mkvesala/CMPS14-ESP32-SignalK-gateway/README.md

# CMPS14-ESP32-SignalK Gateway








## Disclaimer

This is a personal hobby project. It is provided "as is", without warranty of any kind. See LICENSE.

This firmware is NOT intended for navigation or for any safety-critical use at sea. Do not rely on the data it produces (such as heading, depth or position) to navigate a vessel. Always use certified navigation equipment and proper seamanship.

You use this code entirely at your own risk. The author accepts no liability for any damage, injury or loss arising from its use.

## Introduction

ESP32-based reader for Robot Electronics [CMPS14](https://www.robot-electronics.co.uk/files/cmps14.pdf) compass & attitude sensor. Sends heading, pitch and roll to [SignalK](https://signalk.org) server via websocket/json and to other ESP32 devices via ESP-NOW.

Applies installation offset, deviation and magnetic variation to raw angle to determine compass heading, magnetic heading and optionally true heading. Computes deviation at any compass heading, based on user-measured deviations at 8 cardinal and intercardinal directions. Subscribes magnetic variation from SignalK server. This is prioritized over manually entered variation to determine true heading.

Uses LCD 16x2 to show status messages and heading. If no wifi around, runs on LCD only.

Runs a webserver to provide web UI for CMPS14 configuration. Configurable parameters: calibration mode (full auto, auto, manual), installation offset, measured deviations, manual variation, heading mode (true, magnetic) and attitude leveling. Web UI protected with session-based authentication.

OTA updates and persistent storage of configuration and web UI password in ESP32 NVS are enabled.

Led indicators for calibration mode and connection status (two leds).

Developed and tested on:
- [SH-ESP32](https://docs.hatlabs.fi/sh-esp32/) development board (2.2.1)
- [ESP32 board package](https://github.com/espressif/arduino-esp32) (3.3.8)
- [Arduino IDE](https://www.arduino.cc/en/software/) (2.3.8)
- SignalK Server (2.24.0)
- CMPS14 sensor (V7)

Integrated via ESP-NOW to:
- [ESP32-Crowpanel-compass multi-function display](https://github.com/mkvesala/ESP32-Crowpanel-compass) (v4.0.0)

## Purpose of the project

This is one of my individual digital boat projects. Use at your own risk. Not for safety-critical navigation.

1. I needed a reliable low-cost digital compass that could be connected to SignalK server of my vessel
2. I wanted to learn ESP32 capabilities for other digital boat projects that are on my backlog
3. I felt I had to refresh my C/C++ skills as I had not delivered any code since 2005 (and before that mostly Java and Smallworld Magik)

The project started as procedural .ino implementation in Arduino. Later, refactoring to class structure was done. That developed into a design pattern that I currently use in all similar sensor projects of my boat.

## Release history

| Release | Branch | Comment |
|---|---|---|
| v2.1.6  | main | Latest release. ArduinoJson 7 API migration: deprecated calls replaced, SignalK traffic unchanged. See CHANGELOG. |
| v2.1.5  | main | WiFi outage recovery: the radio stays on, so ESP-NOW keeps broadcasting while the router is down, and WiFi and SignalK reconnect by themselves. See CHANGELOG. |
| v2.1.4  | main | Shared `espnow_protocol.h` synced with the fleet-wide copy (adds `HALMET_OIL_DELTA` (10)). Wire format unchanged, no firmware logic changes. See CHANGELOG. |
| v2.1.3  | main | Magnetic variation is subscribed from SignalK immediately when heading mode is switched to True (no reconnect needed). README: MCP integration section, `MCP_API_TOKEN` in secrets example, cross-check fixes. See CHANGELOG. |
| v2.1.2  | main | Documentation update only. |
| v2.1.1  | main | Shared `espnow_protocol.h` synced to the fleet-wide superset (new message types 7 and 8, ownership rules documented). Wire format unchanged, no firmware logic changes. See CHANGELOG. |
| v2.1.0  | main | Machine-readable `/deviations` JSON endpoint and static API-token (`X-Auth-Token`) auth for machine clients (e.g. the `mcp-cmps14/` MCP tool). Additive, backward compatible. See CHANGELOG. |
| v2.0.0  | main | ESP-NOW level command removed. WiFi AP security, intrusion detection, pitch/roll SignalK fix, WebSocket ping/pong liveness. See CHANGELOG. |
| v1.3.1  | main | Documentation patch, no source code changes. |
| v1.3.0  | main | Breaking change in ESP-NOW wire protocol. See CHANGELOG for details. |
| v1.2.0  | main | Added ESP-NOW communication. See CHANGELOG for details. |
| v1.1.0  | main | Added web authentication. See CHANGELOG for details. |
| v1.0.1  | main | See CHANGELOG for details. |
| v1.0.0  | main | Refactored into classes with new features not implemented in v0.5.x. |
| v0.5.1  | legacy/procedural-0.5.x | Last fully procedural version. |

## Classes

### Class CMPS14Sensor

The heart of the project is the modest library-like class `CMPS14Sensor` which communicates with the CMPS14 device. It has the following public API:

| Method | Returns | Comment |
|---|---|---|
| `begin(TwoWire &wirePort)` | `bool` | Initialize sensor |
| `available()` | `bool` | Check the availablility of the sensor |
| `read(float &angle_deg, float &pitch_deg, float &roll_deg)` | `bool` | Read sensor raw values (degrees) to the float variables |
| `sendCommand(uint8_t cmd)` | `bool` | Send any command to the sensor |
| `readRegister(uint8_t reg)` | `uint8_t` | Read any register of the sensor |
| `isAck(uint8_t byte)` | `bool` | Return true if byte is ACK |
| `isNack(uint8_t byte)` | `bool` | Return true if byte is NACK |

The simple usage of CMPS14Sensor could be:

```
#include <Arduino.h>
#include <Wire.h>
#include "CMPS14Sensor.h"

CMPS14Sensor sensor(0x60); // I2C address

void setup() {
   Serial.begin(115200);
   Wire.begin(16, 17); // SDA, SCL
   delay(100);
   sensor.begin(Wire);
}

void loop() {
   const unsigned long now = millis();
   static unsigned long last = 0;
   if ((long)(now - last) < 1000) return; // Read at 1 Hz
   float angle_deg = 0.0f, pitch_deg = 0.0f, roll_deg = 0.0f;
   if (sensor.available() && sensor.read(angle_deg, pitch_deg, roll_deg)) {
      Serial.println(angle_deg);
      Serial.println(pitch_deg);
      Serial.println(roll_deg);
   }
}

```
### Other classes

Class diagram including companion projects:



**`CMPS14Processor`:** 
- Owns: `DeviationLookup`
- Uses: `CMPS14Sensor`, `CalMode` and `TwoWire`
- Owned by: `CMPS14Application`
- Responsible for: the main business logic, acts as "the compass"

**`CMPS14Preferences`:** 
- Owns: `Preferences`
- Uses: `CMPS14Processor` and `CalMode`
- Owned by: `CMPS14Application`
- Responsible for: loading and saving data to ESP32 NVS

**`SignalKBroker`:** 
- Owns: `WebsocketsClient` (via `std::unique_ptr`, recreated fresh on every reconnect)
- Uses: `CMPS14Processor`
- Owned by: `CMPS14Application`
- Responsible for: communication with SignalK server

**`ESPNowBroker`:** 
- Uses: `CMPS14Processor`
- Owned by: `CMPS14Application`
- Responsible for: communication via ESP-NOW protocol

**`DisplayManager`:**
- Owns: `LiquidCrystal_I2C`
- Uses: `CMPS14Processor`, `SignalKBroker`, `WifiState` and `CalMode`
- Owned by: `CMPS14Application`
- Responsible for: LCD display and LEDs, acts as "the display"

**`WebUIManager`:**
- Owns: `WebServer`
- Uses: `CMPS14Processor`, `CMPS14Preferences`, `SignalKBroker`, `DisplayManager` and `CalMode`
- Owned by: `CMPS14Application`
- Responsible for: providing web user interface, acts as "the webui"

**`CMPS14Application`:**
- Owns: `CMPS14Sensor`, `CMPS14Processor`, `CMPS14Preferences`, `SignalKBroker`, `ESPNowBroker`, `DisplayManager` and `WebUIManager`
- Uses: `WifiState` and `CalMode`
- Responsible for: orchestrating everything within the main program, acts as "the app"

**`DeviationLookup`:**
- Owned by: `CMPS14Processor`
- Responsible for: deviation lookup table

**`CalMode`:**
- Global enum class for different calibration modes of CMPS14

**`WifiState`:**
- Global enum class for different WifiStates maintained and shared by `CMPS14Application` 

## Features

### Compass and attitude

1. Reads angle, pitch and roll from CMPS14 at ~20 Hz frequency
2. Applies installation offset (user input) to raw angle for compass heading
3. Applies smoothing to compass heading
4. Applies deviation on compass heading for magnetic heading
5. Computes true heading (optional), using either
   - Live *navigation.magneticVariation* received from SignalK (prioritized over user input)
   - Manual variation from user input on web UI (used automatically whenever *navigation.magneticVariation* is not available)
6. Applies leveling to pitch and roll
7. Installation offset, selected heading mode and pitch/roll leveling are stored persistently in ESP32 NVS and restored automatically on boot

### Deviation

1. Takes 8 user-measured deviations (N, NE, E, SE, S, SW, W, NW) as input from web UI
2. Computes 5 harmonic coefficients (A, B, C, D, E) that best fit the mathematical model `deviation(θ) = A + B·sin(θ) + C·cos(θ) + D·sin(2θ) + E·cos(2θ)` using least squares regression and Gauss-Jordan elimination, providing smooth sinusoidal curve through all 8 user-measured points
3. User-measured deviations and computed 5 coeffs are stored persistently in ESP32 NVS
4. A deviation lookup table is computed each time the 5 coeffs change and on ESP32 boot. The lookup table contains the deviation for each 1° over 360°. The lookup method will apply a linear interpolation for better accuracy when retrieving a value from the lookup table at a compass heading.
5. Deviation curve and deviation table at simplified 10° resolution available on web UI

**Note that deviation can be applied only to a permanently mounted stable compass. While CMPS14 can be securely mounted to the vessel, it's behavior may still be altered by calibration (automatic or manual). It is recommended to keep deviation at 0° until there are undeniable evidence that the compass is stable and operating without any needs for regular calibration. It's obvious that the deviations should always be re-measured and computed after each calibration.**

### Magnetic variation

1. When heading mode is True, subscribes *navigation.magneticVariation* path from SignalK server at ~1 Hz cycles. This is treated as primary and the most trusted source of magnetic variation. The subscription is sent when the SignalK WebSocket connection opens and, if the connection is already open, immediately when the heading mode is switched to True on the web UI.
2. User may enter magnetic variation manually on the web UI. This is a backup and the value will be used automatically if variation is not available at SignalK path.
3. User-defined manual variation is persistently stored in ESP32 NVS.
4. Magnetic variation is used for computing true heading on magnetic heading.

**Note that when the SignalK connection is open, the magnetic heading will always be sent to SignalK *navigation.headingMagnetic* path regardless of the active heading mode (true/magnetic). It is a standard practise to compute true heading on server side using SignalK [Derived Data](https://github.com/SignalK/signalk-derived-data) plugin or similar, or on other clients such as [OpenCPN](https://opencpn.org) that utilize [WMM](https://www.ncei.noaa.gov/products/world-magnetic-model).**

**Note that ESP-NOW packet always contains both true and magnetic heading, regardless of the active heading mode.**

### SignalK communication

Connects to:
```
ws://<server>:<port>/signalk/v1/stream?token=<optional>
```

**Sends** at maximum ~10 Hz frequency, in radians:

- *navigation.headingMagnetic* — sent when heading changes by more than 0.05°
- *navigation.attitude.pitch* — included in every heading delta
- *navigation.attitude.roll* — included in every heading delta
- *(optionally) navigation.headingTrue*

**Receives** at ~1 Hz frequency, in radians:

1. *navigation.magneticVariation* (if available at SignalK, subscribed only when heading mode is True)

**Please refer to Security section of this file.**

### Connection resilience

The SignalK WebSocket is kept alive and recovered on multiple layers:

- **Ping/pong liveness (primary):** while the socket is open the gateway sends a client ping every ~10 s (`WS_PING_MS`) and timestamps every server pong. If no pong arrives within ~30 s (`PONG_TIMEOUT_MS`), `SignalKBroker::isStale()` reports the connection dead and the gateway closes and reconnects it — a **graceful transport-level reconnect, without restarting the device**, so uptime, ESP-NOW peers and the display state are preserved. This catches the *half-open TCP* failure mode where WiFi and `isOpen()` still look healthy but the server side has silently frozen (e.g. the SignalK host entering power-saving).
- **Exponential backoff:** when the socket is closed, reconnect attempts start at `WS_RETRY_MS` (~2 s) and double up to `WS_RETRY_MAX_MS` (~2 min).
- **Fresh client per reconnect:** `SignalKBroker` owns the `WebsocketsClient` via `std::unique_ptr`; each reconnect builds a brand-new client and destroys the previous one, so every attempt starts from a clean TCP / lwIP socket state. This prevents a stuck underlying socket from making all future reconnects fail permanently until a reboot — a failure mode that could appear only after prolonged uptime (~12–48 h) even while WiFi, heap and the main loop stayed healthy.
- **Watchdogs (last-resort fallback):** the network watchdog (`ESP.restart()` after ~10 min of a silent-but-associated link) and the loop-runtime watchdog (restart if the loop runtime EMA stays degraded) remain in place as a safety net. Individual iteration times are clamped (`LOOP_SAMPLE_CAP_US`) before entering the EMA, so a single blocking call — a `ws.connect()` against an unreachable host, the WiFi teardown delay — cannot trip the watchdog on its own; the unclamped peak is still reported on the LCD and in `/status` (`runtime_peak`) for diagnostics. With ping/pong liveness handling the common case, both watchdogs are expected to stay dormant and may be removed in a future release once liveness is field-proven.
- **Restart cause is preserved:** whichever watchdog fires — and likewise a restart from the web UI — records its reason to NVS before rebooting, so `/status` reports it as `last_reset` after the device comes back. The stored reason is consumed on boot, so it always describes only the previous restart. Crashes that never reach the NVS write (panic, brownout) are covered by the separate `esp_reset` field, taken from ESP-IDF's `esp_reset_reason()`.

### ESP-NOW communication

Broadcasts compass data via ESP-NOW protocol for other ESP32 devices such as external displays.

Since v1.3.0 all ESP-NOW messages use the shared `ESPNow::ESPNowPacket` (`ESPNowHeader` + typed payload) packet wrapper defined in `espnow_protocol.h` along with the typed payload structs.

**Sends** at ~20 Hz frequency with a deadband of 0.05°:
- `ESPNow::ESPNowPacket<HeadingDelta>` - payload `HeadingDelta` containing:
  - `heading_rad` (magnetic heading radians)
  - `heading_true_rad` (true heading radians)
  - `pitch_rad` (pitch radians)
  - `roll_rad` (roll radians)

**Broadcast mode:** Uses broadcast address (FF:FF:FF:FF:FF:FF) - any ESP-NOW receiver on the same WiFi channel can listen.

**WiFi coexistence:** ESP-NOW operates alongside WiFi (AP_STA mode). Both SignalK WebSocket and ESP-NOW broadcast function simultaneously.

**WiFi outage:** if the router goes down, ESP-NOW keeps broadcasting: the radio stays on in `WIFI_AP_STA` mode, held on `ESPNOW_CHANNEL` (6) between attempts. Each connection attempt lasts up to ~15 s and retries back off from ~30 s to ~2 min, so WiFi and SignalK return without a reboot.

**Note: ESP-NOW receivers must be on the same WiFi channel as the compass. Simplest approach is to connect both devices to the same WiFi network with a fixed channel.**

### Calibration modes

Three supported calibration modes and use-mode for normal operation:

1. *FULL AUTO* - CMPS14's built-in autocalibration & autosave + optional user configurable stop timer
2. *AUTO* - auto-detect good enough calibration to save automatically
3. *MANUAL* - user-triggered calibration with manual save/replace
4. In *USE* mode the CMPS14 operates normally based on saved calibration profile (no calibration is running).

When calibration is running, *SYS*, *ACC* and *MAG* indicators are monitored at ~2 Hz frequency.

*FULL AUTO* and *AUTO* will activate on ESP32 boot. The *FULL AUTO* will run until the user configured stop timer or eternally if the timer is set to 0. The *AUTO* will run until all three indicators equal 3 (the best) over three consecutive cycles, then the calibration profile will be saved and *USE* mode will be activated. When *USE/MANUAL* is selected, no calibration will be started on ESP32 boot. Instead, the device will start directly to *USE* mode. In *MANUAL* mode (press *CALIBRATE*) user may decide when to save by monitoring the values on web UI status block.

The calibration mode selection (including optional *FULL AUTO* timeout) is stored persistently in ESP32 NVS.

The calibration profile is saved on CMPS14 internally, *not* in ESP32 NVS.

**Note that CMPS14's *GYR* indicator for gyro is not monitored. There is a reported firmware bug in CMPS14 that makes *GYR* indicator unreliable.**

### Web UI (WebServer)

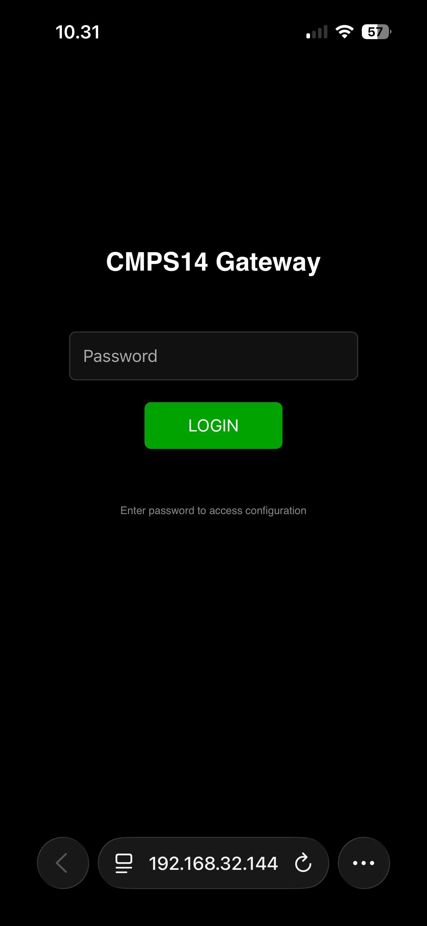
[picture p1: docs/ui0.jpeg]
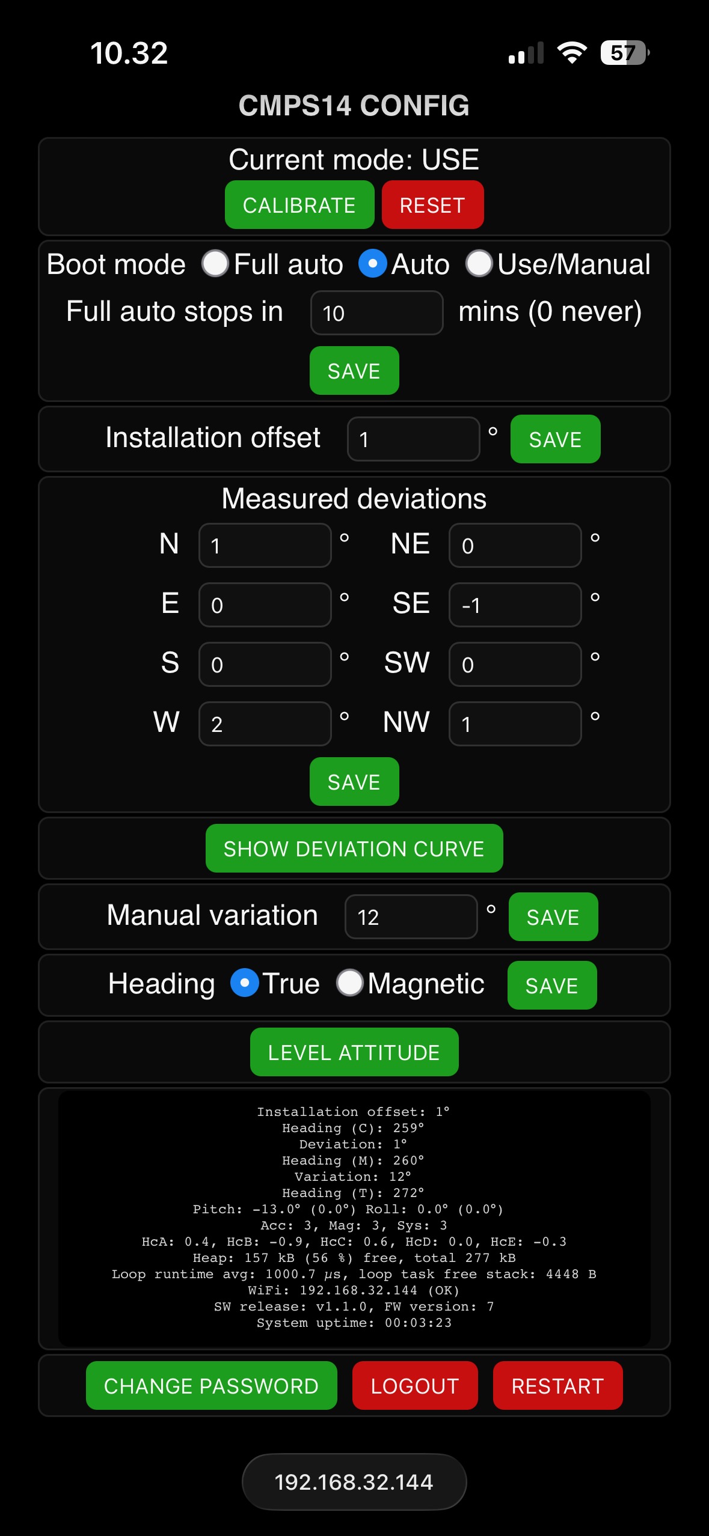
[picture p2: docs/ui1.jpeg]
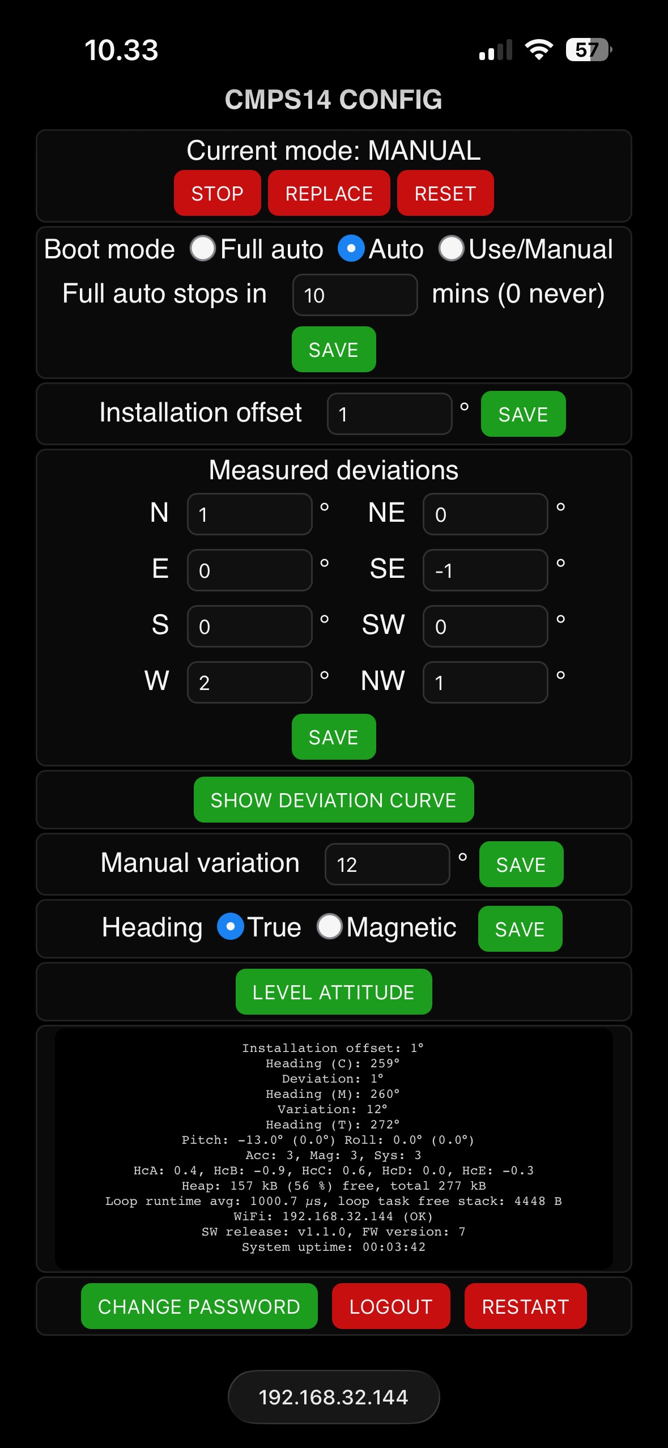
[picture p3: docs/ui2.jpeg]
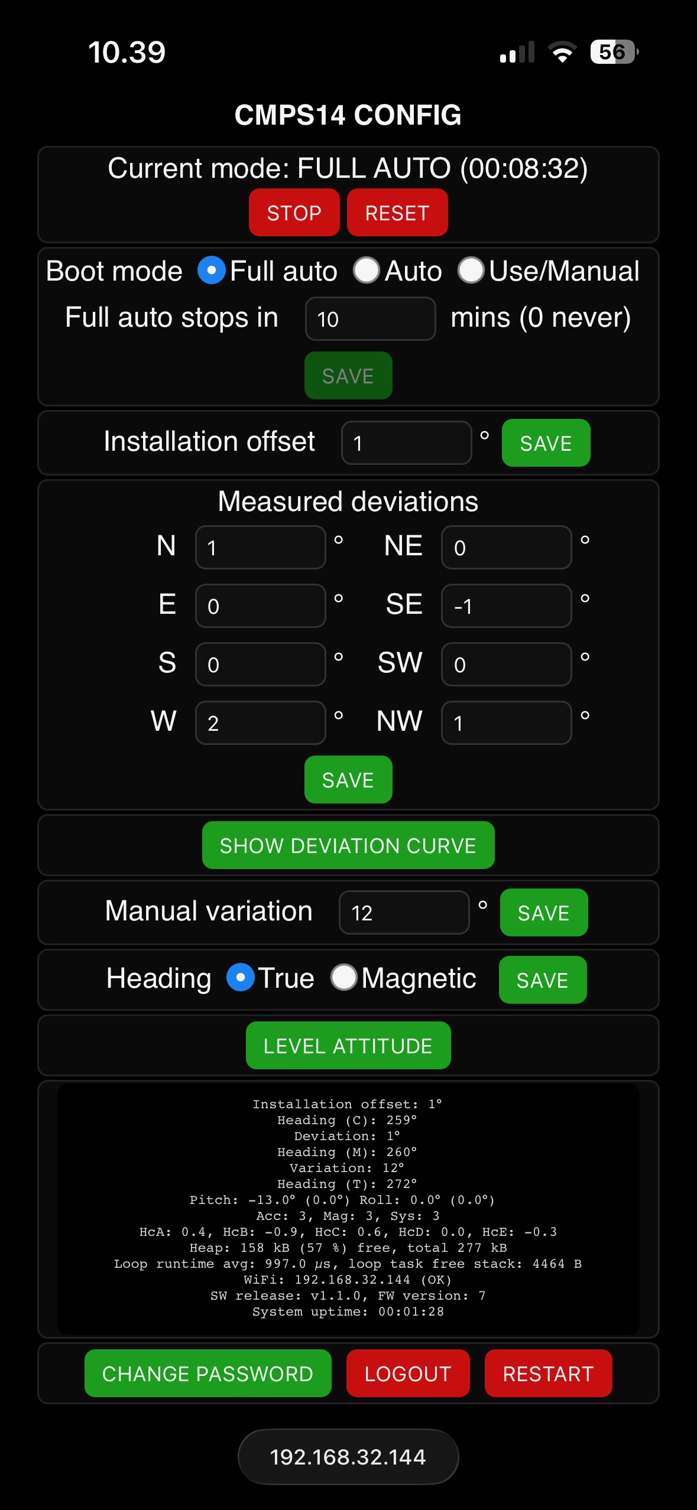
[picture p4: docs/ui3.jpeg]
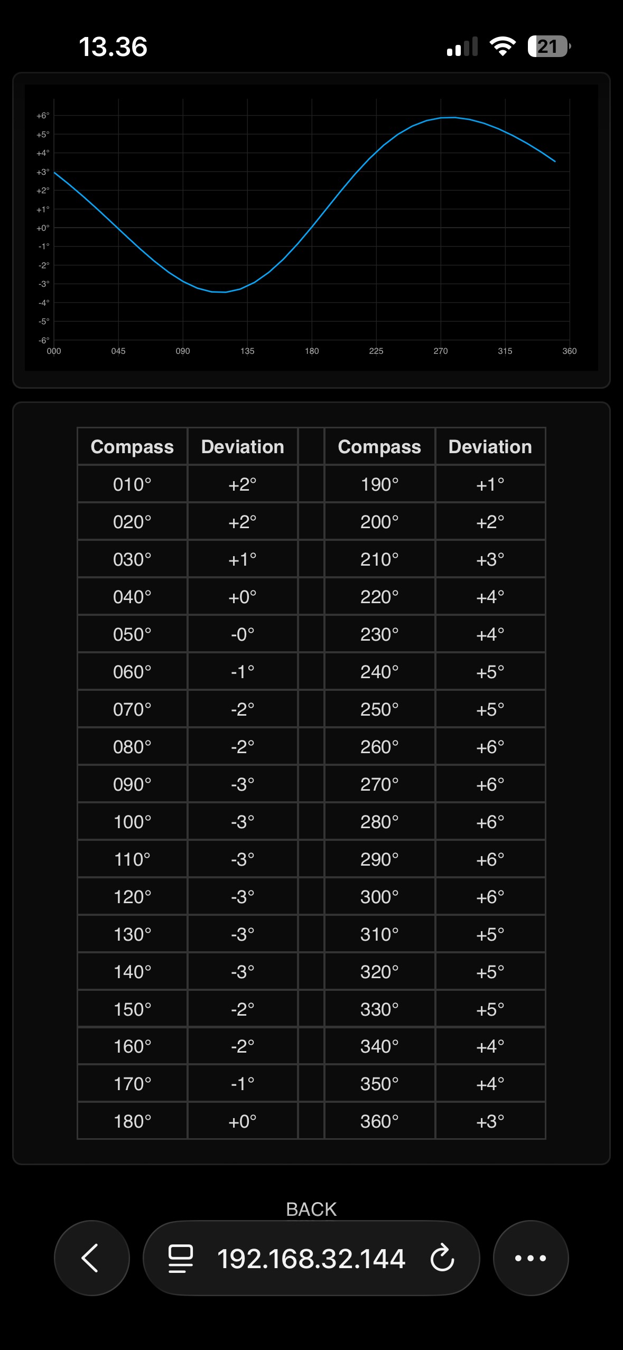
[picture p5: docs/ui4.jpeg]
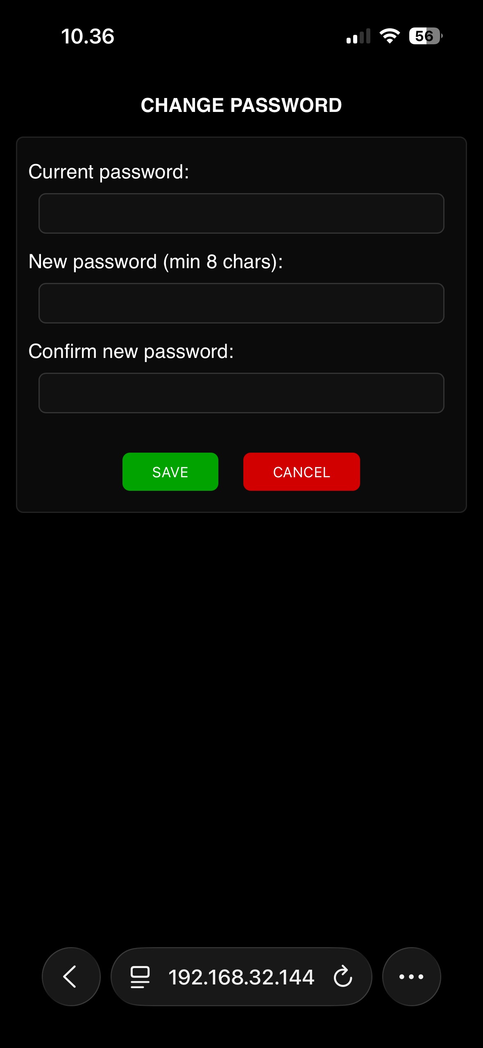
[picture p6: docs/ui5.jpeg]
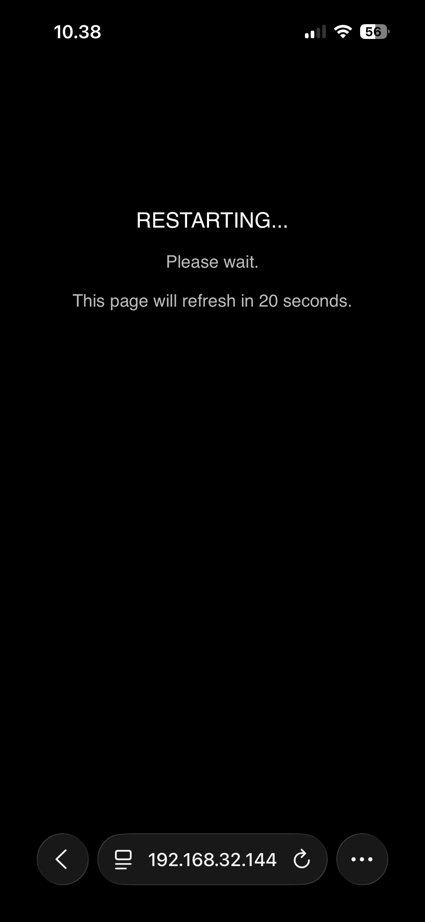
[picture p7: docs/ui6.jpeg]
      

Webserver provides simple responsive HTML/JS user interface for user to configure:

1. Calibration mode on boot and optional *FULL AUTO* timeout (mins)
   - 0 mins timeout never turns *FULL AUTO* mode off automatically
   - Effective after ESP32 boot
2. Installation offset (degrees)
   - Positive offset corrects the heading *towards* starboard, meaning that the compass mounting is tilted port side
   - Negative offset corrects the heading *towards* port side, meaning that the compass mounting is tilted starboard
   - Effective immediately
3. Measured deviations at 8 cardinal and intercardinal directions (degrees)
   - Assumes the user has measured deviations with the standard maritime navigation routine:
     ```
     HDG(C) -> Dev -> HDG(M) -> Var -> HDG(T)
     ```
   - Effective immediately
4. Manual magnetic variation (degrees)
   - Positive value is E, negative value is W
   - Effective immediately, however SignalK *navigation.magneticVariation* will be used instead whenever available
5. Heading mode (true/magnetic)
   - True is the default
   - Magnetic heading will always be sent to SignalK *navigation.headingMagnetic* path, also when True is selected
   - Effective immediately
  
All above are stored persistently in ESP32 NVS and will be automatically retrieved on ESP32 boot.

Additionally the user may:

1. Start the calibration by pressing *CALIBRATE* in *MANUAL* mode
2. *STOP* the calibration in all calibration modes without saving calibration profile
3. *SAVE* the calibration profile in *AUTO* and *MANUAL* calibration modes
   - If calibration profile has already been saved since ESP32 boot, the *REPLACE* button is shown instead of *SAVE*
4. *RESET* CMPS14 to factory settings
   - There is a 600 ms delay after reset in the background, doubling the delay from data sheet recommendation
   - Reset does *not* reset configuration settings stored in NVS, *except* the pitch/roll leveling factors which are cleared to zero (the sensor registers are reset, so the stored leveling is reset with them)
5. *SHOW DEVIATION CURVE*
   - Opens a new page with a back-button pointing to the configuration page
   - Simplified deviation curve and deviation table presented 0...360° with 010° resolution
6. *LEVEL ATTITUDE* to zero
   - Takes the negation of the latest pitch and roll to capture the leveling factors for attitude
   - Leveling factors are applied to the raw pitch and roll
   - Thus, user may reset the attitude to zero at any vessel position to start using proportional pitch and roll
   - Leveling is not incremental
   - The leveling factors are stored persistently in ESP32 NVS and restored automatically on boot, so a restart (including a watchdog-triggered self-restart) preserves the leveling; only *RESET* clears them
7. *RESTART* the system
   - Opens a temporary page which will refresh back to the configuration page after 20 seconds
   - In the background, the restart will be executed ~5 seconds after pushing the button
   - Calls `ESP.restart()` of `esp_system`
8. View the parameters on status block
   - JS generated block that updates at ~1 Hz cycles
   - Shows: installation offset, compass heading, deviation on compass heading, magnetic heading, effective magnetic variation, true heading, pitch (leveling factor), roll (leveling factor), 3 calibration status indicators, 5 coeffs of harmonic model, debug heap memory status, debug loop task average runtime and free loop task stack memory, IP address and wifi signal level description, software version, CMPS14 firmware version, system uptime
9. *CHANGE PASSWORD* for web UI authentication
    - Opens a page for user to change the web UI password
    - Minimum 8 characters
10. *LOGOUT* from web UI
    - Clears session

### Web UI authentication

The web UI is protected by session-based authentication.

**Default password:** defined in `secrets.h`.

**First login:**
1. On first boot, LCD displays "DEFAULT PASSWORD! CHANGE NOW!"
2. Navigate to `http://<esp32ipaddress>/`
3. Enter default password
4. Change password immediately after first login via *CHANGE PASSWORD* button

**Password:**
- Minimum 8 characters
- Stored as SHA256 hash in NVS
- Persistent, survives ESP32 reboots

**Session Management:**
- Sessions valid for 6 hours
- Automatic timeout on inactivity
- Up to 3 concurrent users
- Logout button available on all pages

### Webserver endpoints

| Path | Method | Auth | Description | Parameters |
|---|---|---|---|---|
| `/` | GET | No | Login page or redirect to `/config` | none |
| `/login` | POST | No | Login handler | `password=<password>`  |
| `/logout` | POST | No | Logout and clear session | none |
| `/changepassword` | GET | Yes | Password change form | none |
| `/changepassword` | POST | Yes | Password change handler | `old=<old_pw>&new=<new_pw>&confirm=<confirm_pw>`  |
| `/config` | GET | Yes | Main UI | none |
| `/cal/on` | POST | Yes | Start calibration | none |
| `/cal/off` | POST | Yes | Stop calibration | none |
| `/store/on` | POST | Yes | Save calibration profile | none |
| `/reset/on` | POST | Yes | Reset CMPS14 | none |
| `/calmode/set` | POST | Yes | Save calibration mode | `c=<0\|1\|2\|3>&t=<0...60>` // 0 = FULL AUTO, 1 = AUTO, 2 = MANUAL, 3 = USE |
| `/offset/set` | POST | Yes | Installation offset | `v=<-180...180>` // Degrees (-) correct towards port side, (+) correct towards starboard  |
| `/dev8/set` | POST | Yes | Eight deviation points | `N=<n>&NE=<n>&E=<n>&SE=<n>&S=<n>&SW=<n>&W=<n>&NW=<n>` // <n> = deviation in degrees |
| `/deviationdetails` | GET | Yes | Deviation curve and table (HTML/SVG) | none |
| `/deviations` | GET | Yes | Deviation data as JSON (8 measured points + 5 harmonic coeffs; `?table=1` adds the full 360-entry, 1° deviation table) | `table=<1>` // optional |
| `/magvar/set` | POST | Yes | Manual variation | `v=<-90...90>` // Degrees (-) west, (+) east |
| `/heading/mode` | POST | Yes | Heading mode | `m=<1\|0>` // 1 = HDG(T), 0 = HDG(M)  |
| `/status` | GET | Yes | Status block | none |
| `/restart` | POST | Yes | Restart ESP32 | `ms=<2999...19999>` // Delay before actual restart in ms, default 2999 (web UI sends 5003) |
| `/level` | POST | Yes | Level CMPS14 attitude | none |

Endpoints can be used by external HTTP clients. Note that state-changing endpoints require POST method, parameters within POST body. For example, to add leveling of attitude to a [KIP](https://github.com/mxtommy/Kip) dashboard, you would create a button that sends a POST request to `http://<esp32ipaddress>/level`.

#### API token authentication (for machine clients)

In addition to the browser session cookie, all authenticated endpoints accept a **static API token** for non-interactive clients (e.g. an MCP tool or dashboard). The client sends the token in the `X-Auth-Token` request header; when it matches, the request is authorized without a login/session.

- Set `MCP_API_TOKEN` in `secrets.h` to a long random value (32+ hex chars) to enable it. Empty (default) disables token auth entirely, leaving behaviour identical to earlier versions.
- The token is compared in constant time and requires at least 16 characters.
- Session-cookie authentication is unchanged; the token is an additive, opt-in alternative.

Example: `curl -H "X-Auth-Token: <token>" "http://<esp32ipaddress>/deviations?table=1"`

**Please refer to Security section of this file.**

### MCP integration (Claude Desktop)

The `mcp-cmps14/` folder contains a small Python [MCP](https://modelcontextprotocol.io) server that lets a **Claude Desktop** agent talk to the gateway over its HTTP API. It authenticates with the static API token (`X-Auth-Token` header, `MCP_API_TOKEN` in `secrets.h`) described above.

| Tool | Gateway call | Purpose |
|---|---|---|
| `get_status()` | `GET /status` | Live heading, deviation, calibration status, health |
| `get_deviations()` | `GET /deviations` | The 8 stored deviation points + harmonic coefficients |
| `get_deviation_table(step=1)` | `GET /deviations?table=1` | Firmware-computed 360-entry (1°) deviation curve |
| `set_deviations(N=…, …, NW=…)` | `POST /dev8/set` | Write deviation points (merge-before-write) |

Typical use: the Claude Desktop agent analyses COG(T)/HDG(T) data (e.g. from InfluxDB), derives the eight deviation values and writes them to the gateway with `set_deviations`. The analysis is done by the agent itself; the MCP tool is only the bridge to the gateway. `set_deviations` reads the current 8 values first and overrides only the directions given, so a partial update never zeroes the others.

Quick setup:
1. Set `MCP_API_TOKEN` in `secrets.h` and reflash the gateway
2. Install the tool (Python 3.11+): `cd mcp-cmps14 && python3 -m venv .venv && .venv/bin/pip install -r requirements.txt`
3. Add a `cmps14` server entry to Claude Desktop's `claude_desktop_config.json` with environment variables `CMPS14_BASE_URL` (e.g. `http://192.168.1.55`), `CMPS14_API_TOKEN` (same value as `MCP_API_TOKEN`) and optionally `CMPS14_TIMEOUT` (seconds, default 5.0)
4. Restart Claude Desktop

See [mcp-cmps14/README.md](mcp-cmps14/README.md) for full installation, configuration and testing instructions.

### LCD 16x2

1. Shows heading (true or magnetic, depending on user preference on web UI)
2. Shows info messages on the way, related to calibration status, user interaction on web UI, OTA update progress etc.
3. LCD shows messages from a message queue on fifo basis, every 1.5 seconds
4. To avoid unnecessary blinking the LCD will refresh only if the content to be shown is different from what's already on the display.

Using different display can be done within `DisplayManager` class while ensuring its public API stays intact for backwards compatibility.

### Two led indicators

1. GPIO2 blue led indicator (built in led on my SH-ESP32 board)
   - Fast ~5 Hz blinking: wifi not connected
   - Medium ~2 Hz blinking: wifi connecting
   - Slow ~1 Hz blinking: wifi connected
   - Solid state: websocket connected to SignalK server
   - Off: I have a bad feeling about this.  
1. GPIO13 green led indicator (additional led soldered onto the board)   
   - Solid state: *USE* mode
   - Fast ~5 Hz blinking: *AUTO* or *MANUAL* calibration mode active
   - Slow ~0.5 Hz blinking: *FULL AUTO* calibration mode active
   - Off: Houston, we have a problem.
  
## Project structure

| File(s) | Description |
|---|---|
| `CMPS14-ESP32-SignalK-gateway.ino` | Owns CMPS14Application app, contains setup() and loop() |
| `secrets.example.h`| Example credentials. Rename to `secrets.h` and populate with your credentials. |
| `version.h` | Software version |
| `espnow_protocol.h` | Shared ESP-NOW protocol definitions (header, payloads, packet wrapper) |
| `CalMode.h` | Enum class for CMPS14 calibration modes |
| `WifiState.h` | Enum class for wifi states |
| `harmonic.h/harmonic.cpp` | Struct and functions to compute deviations, class DeviationLookup |
| `CMPS14Sensor.h/CMPS14Sensor.cpp` | Class CMPS14Sensor, the "sensor" |
| `CMPS14Processor.h/CMPS14Processor.cpp` | Class CMPS14Processor, the "compass" |
| `CMPS14Preferences.h/CMPS14Preferences.cpp` | Class CMPS14Preferences, the "compass_prefs" |
| `SignalKBroker.h/SignalKBroker.cpp` | Class SignalKBroker, the "signalk" |
| `ESPNowBroker.h/ESPNowBroker.cpp` | Class ESPNowBroker, the "espnow" |
| `DisplayManager.h/DisplayManager.cpp` | Class DisplayManager, the "display" |
| `WebUIManager.h/WebUIManager.cpp` | Class WebUIManager, the "webui" |
| `CMPS14Application.h/CMPS14Application.cpp` | Class CMPS14Application, the "app" |
| `mcp-cmps14/` | Optional Python MCP server for Claude Desktop (see [MCP integration](#mcp-integration-claude-desktop)) |

## Hardware

### Schematic

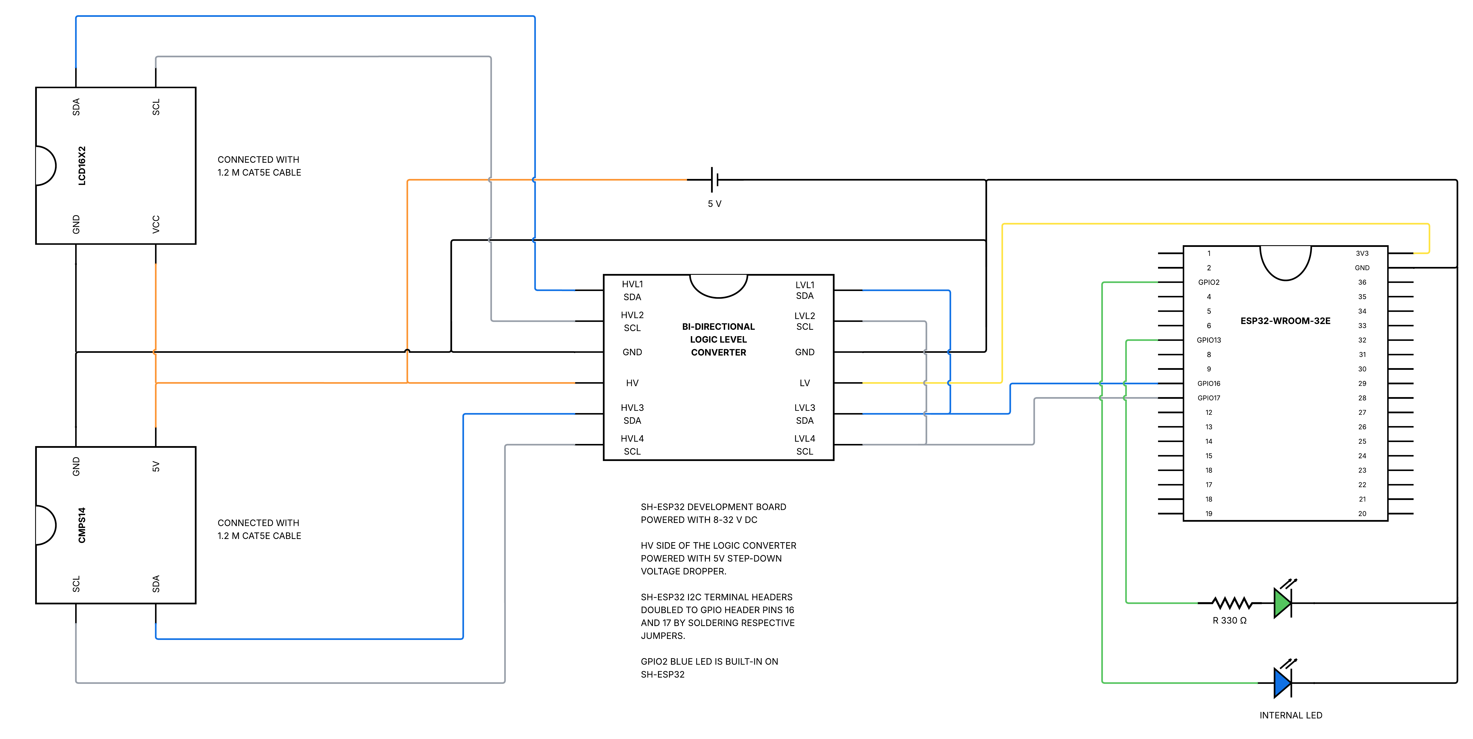
[picture p8: docs/schematic.png]


### Bill of materials

1. ESP32 module (developed and tested with SH-ESP32 board)
2. CMPS14 sensor (I2C mode) connected with 1.2 m CAT5E network cable
3. LCD 16x2 module(with I2C backpack) connected with 1.2 m CAT5E network cable
4. LEDs
   - blue led at GPIO2 (built-in led on SH-ESP32 board)
   - green led at GPIO13 in series with 330 ohm resistor
5. Sparkfun bi-directional [logic level converter](https://www.sparkfun.com/sparkfun-logic-level-converter-bi-directional.html)
   - SH-ESP32 runs 3.3 V internally
   - CMPS14 accepts both 3.3 V and 5 V
   - LCD accepts both 3.3 V and 5 V but is sharper with 5 V
   - Soldered logic level converter onto the board and used 5 V both for CMPS14 and LCD (I2C comms)
6. Joy-IT step-down [voltage converter](https://joy-it.net/en/products/SBC-Buck04-5V)
   - SH-ESP32 accepts 8 - 32 V, this is step-down to 5 V for CMPS14 and LCD
7. IP67 enclosures for CMPS14 and SH-ESP32, cable glands and SP13 connectors
8. Jumper wires, male row headers (2.54 mm)
9. 3D printed [panel mount bezel](https://www.printables.com/model/158413-panel-mount-16x2-lcd-bezel) for LCD 16x2 (temporarily a black 2 x 4 x 1 inch plastic box with a cut hole)
10. Wifi router providing wireless LAN AP
11. MacOS laptop in LAN running SignalK server

**No paid partnerships.**

## Software used

1. Arduino IDE 2.3.8
2. Espressif Systems esp32 board package 3.3.8
3. Additional libraries installed:
   - ArduinoWebsockets (by Gil Maimon version 0.5.4)
   - ArduinoJson(by Benoit Blanchon version 7.4.3)
   - ArduinoOTA (by Arduino, Juraj Andrassy version 1.1.1)
   - LiquidCrystal_I2C (by Frank de Brabander version 1.1.2)

## Installation

1. Clone the repo
   ```
   git clone https://github.com/mkvesala/CMPS14-ESP32-SignalK-gateway.git
   ```
2. Alternatively, download the code as zip
3. Set up your credentials in `secrets.h` (first by renaming the `secrets.example.h` to `secrets.h`)
   ```
   inline constexpr const char* WIFI_SSID            = "your_wifi_ssid_here";
   inline constexpr const char* WIFI_PASS            = "your_wifi_password_here";
   inline constexpr const char* SK_HOST              = "your_signalk_address_here";
   inline constexpr uint16_t    SK_PORT              = 3000;
   inline constexpr const char* SK_TOKEN             = "your_signalk_auth_token_here";
   inline constexpr const char* OTA_PASS             = "your_OTA_password_here";
   inline constexpr const char* DEFAULT_WEB_PASSWORD = "your_default_web_password_here";
   inline constexpr const char* AP_SSID              = "your_ap_ssid_here";   // hidden, name not critical
   inline constexpr const char* AP_PASS              = "your_ap_password_here"; // min 8 chars (WPA2)
   inline constexpr const char* WIFI_STATIC_IP       = "192.168.1.55";  // static IP for ESP32, outside router DHCP pool
   inline constexpr const char* WIFI_GATEWAY         = "192.168.1.1";   // router/gateway address
   inline constexpr const char* WIFI_SUBNET          = "255.255.255.0"; // subnet mask
   inline constexpr const char* MCP_API_TOKEN        = "";              // optional API token for machine clients, empty = disabled
   ```

   **Note:** the ESP32 always configures itself with the static IP, gateway and subnet mask above (no enable/disable flag). Choose `WIFI_STATIC_IP` outside your router's DHCP address range to avoid IP conflicts.

   **Note:** `MCP_API_TOKEN` is optional. Leave it empty (`""`) to disable token authentication entirely. To enable it, e.g. for the [MCP tool](#mcp-integration-claude-desktop), set a long random value (32+ hex chars, minimum 16 characters), for example generated with `python3 -c "import secrets; print(secrets.token_hex(24))"`. See [API token authentication](#api-token-authentication-for-machine-clients).
4. **Make sure that `secrets.h` is listed in your `.gitignore` file**
5. Connect CMPS14 and optionally LCD to the I2C pins of your ESP32 board
6. Connect and power up the ESP32 with the USB cable
7. Compile and upload with Arduino IDE (ESP tools and required libraries installed)
8. Open browser --> navigate to ESP32 webserver's ip-address for web UI (make sure you are in the same network with the ESP32)
9. Login with the default web password
10. **Change the web password immediately after first login**

**Please refer to Security section of this file.**

Calibration procedure is documented on CMPS14 datasheet.

## Todo

Check [issues](https://github.com/mkvesala/CMPS14-ESP32-SignalK-gateway/issues).

## Debug

Long term observations on release v2.0.0 running on SH-ESP32 board, LCD connected, wifi connected, SignalK server up/down randomly, ESP-NOW broadcasting:

- Free heap memory (from `ESP.getFreeHeap()`): approximately 153 kB (55 %) free, total being 277 kB - does not vary that much
- Loop runtime exponential moving average (alpha 0.01): approximately 1 ms
- Loop task free stack (from `uxTaskGetStackHighWaterMark(NULL)`): stays above 4300 bytes

## Security

### Maritime navigation

**Use at your own risk - not for safety-critical navigation!**

### WiFi AP interface

The ESP32 operates in `WIFI_AP_STA` mode to allow ESP-NOW and WiFi to coexist. The AP interface is not intended for external client connections and is secured with three layers of defence:

1. **Hidden SSID** — AP network is not advertised, invisible to scanners
2. **WPA2 password** — `AP_PASS` from `secrets.h` (minimum 8 characters required)
3. **Immediate deauth + alert** — if a station connects despite layers 1–2, it is deauthenticated immediately via `esp_wifi_deauth_sta()`, the MAC address is shown on LCD (`AP: INTRUDER!`)

`AP_SSID` and `AP_PASS` must be defined in `secrets.h`.

### Authentication

WebServer endpoints are protected by session-based authentication:
- SHA256 password hashing (no plaintext storage)
- Hardware random session tokens (128-bit)
- HttpOnly cookies
- Login throttling (5-minute lockout after 5 failed attempts)
- Automatic session timeout (6 hours)

### Important security considerations

1. **HTTP only (No HTTPS)**
   - Passwords and session tokens transmitted in plaintext
   - Use only on private, trusted networks

2. **LAN deployment only**
   - Do NOT expose to public internet
   - Keep ESP32 on isolated WiFi
   - Use WPA2/WPA3 encryption

3. **SignalK token visibility**
   - SignalK authentication token visible in WebSocket URL
   - Keep ESP32 and SignalK server on same private network

4. **Change default web password**
   - Default web password is weak
   - Change immediately after first login
   - Use strong password (8+ chars, mixed case, numbers)

5. **Login throttling**
   - IP-based light weight tracking of failed login attempts
   - 5-minute lockout after 5 failed attempts
   - Tracks max 5 IP addresses simultaneously
  
6. **`secrets.h`**
   - Make sure that `secrets.h` is listed in your `.gitignore` file

7. **API token (`MCP_API_TOKEN`)**
   - Grants full access to all authenticated endpoints without login, keep it secret
   - Transmitted in plaintext over HTTP (`X-Auth-Token` header)
   - Leave empty if not needed; rotate by changing it in `secrets.h` and reflashing

### Deployment

**Recommended:**
- Deploy on private isolated boat WiFi
- Change default password immediately
- Use WPA2/WPA3 WiFi encryption

**Not Recommended:**
- Public internet exposure
- Port forwarding to ESP32
- Using default password in production
- Sharing WiFi network with untrusted devices

## Credits

Developed and tested using HW and SW listed in this document.

Inspired by [Magnetix - a digital compass with NMEA2000](https://open-boat-projects.org/en/magnetix-ein-digitaler-kompass-mit-nmea2000/).

ESP32 Webserver [Beginner's Guide](https://randomnerdtutorials.com/esp32-web-server-beginners-guide/).

No paid partnerships.

This is a companion project to [ESP32-Crowpanel-compass](https://github.com/mkvesala/ESP32-Crowpanel-compass), [BME280-ESP32-SignalK-gateway](https://github.com/mkvesala/BME280-ESP32-SignalK-gateway), [UBLOX-ESP32-SignalK-gateway](https://github.com/mkvesala/UBLOX-ESP32-SignalK-gateway), [VEDirect-ESP32-SignalK-gateway](https://github.com/mkvesala/VEDirect-ESP32-SignalK-gateway) and [HALMET-ESP32-SignalK-gateway](https://github.com/mkvesala/HALMET-ESP32-SignalK-gateway). See below diagram how these projects relate:



Developed by Matti Vesala in collaboration with Claude Code.

Check [CONTRIBUTING.md](CONTRIBUTING.md) for further development in the project.

I would highly appreciate improvement suggestions as well as any Arduino-style ESP32/C++ coding advice. 

## Gallery

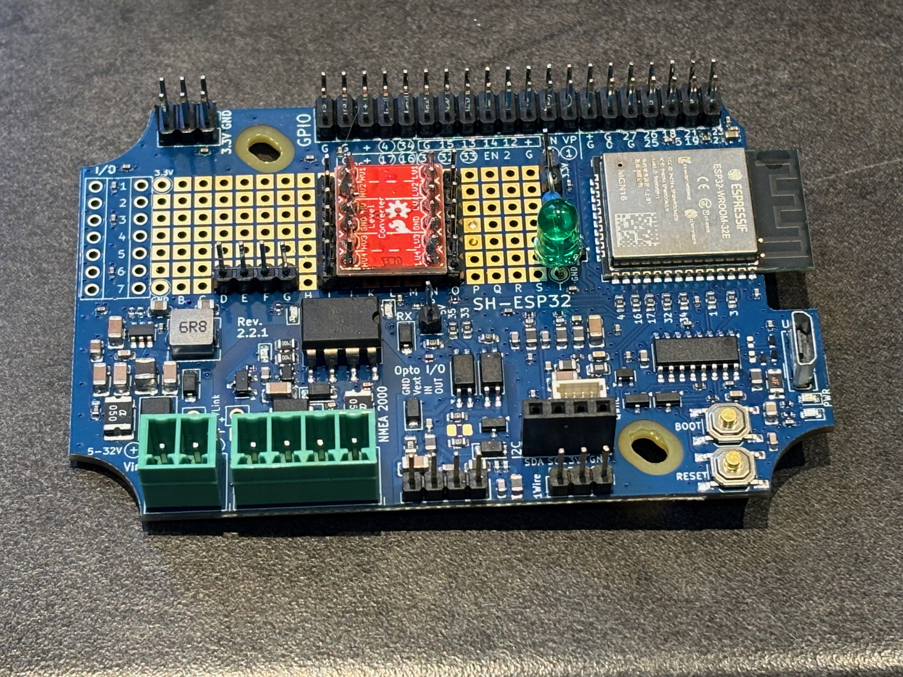
[picture p9: docs/project1.jpeg]
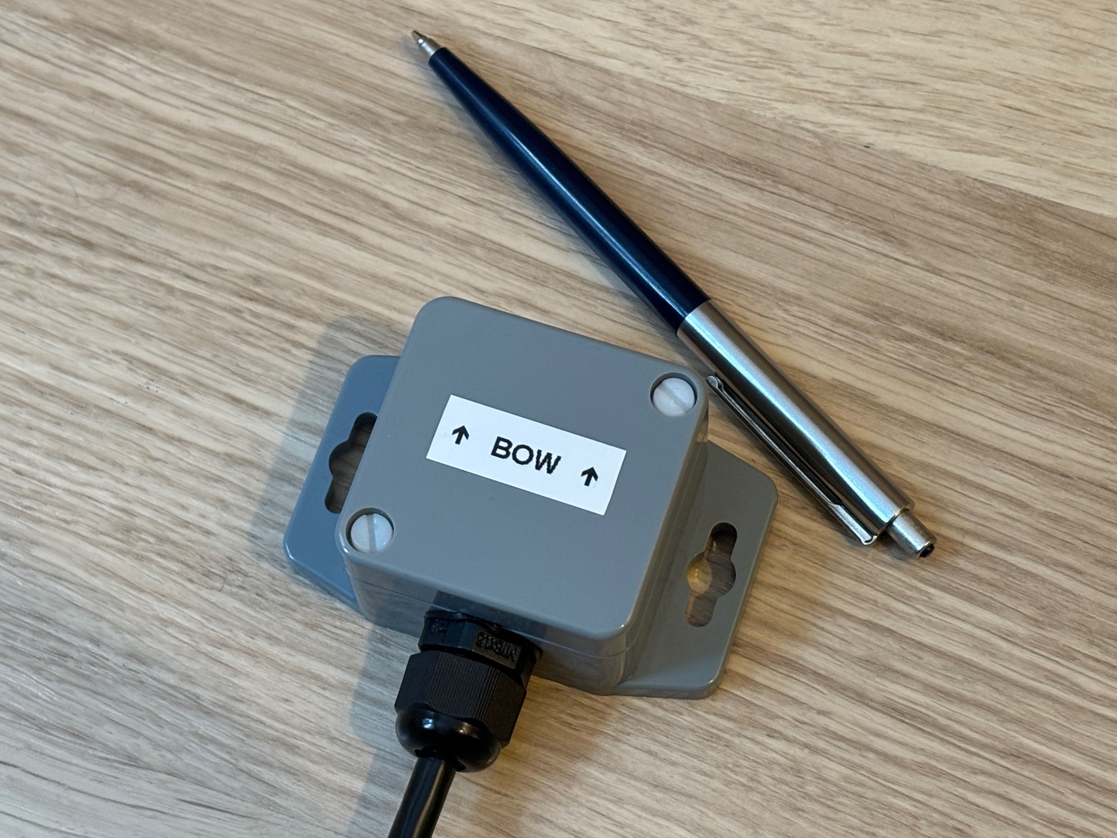
[picture p10: docs/project2.jpeg]
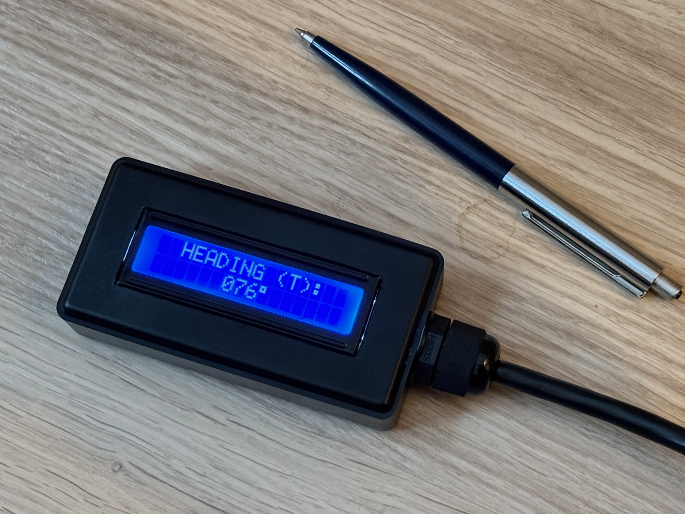
[picture p11: docs/project3.jpeg]
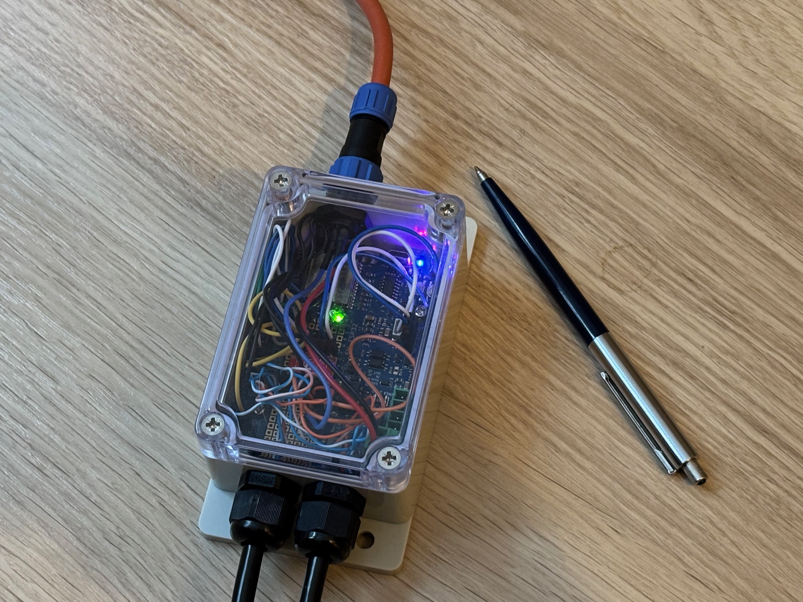
[picture p12: docs/project4.jpeg]
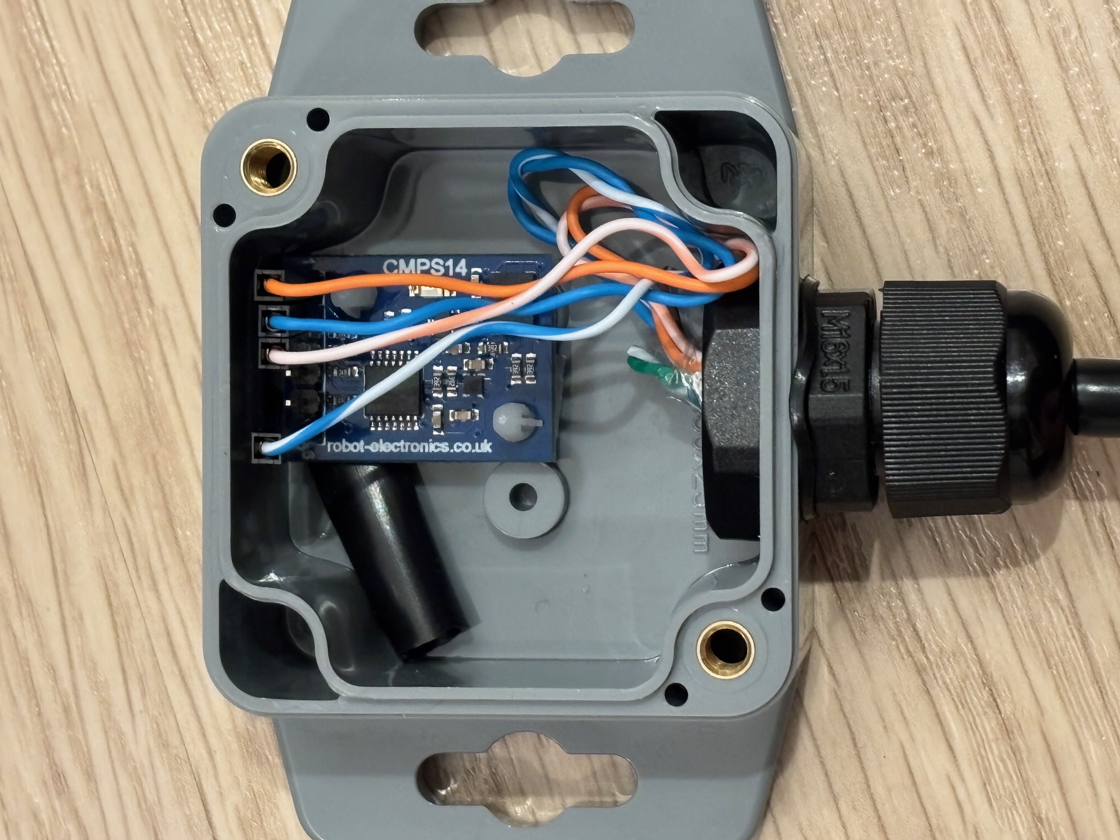
[picture p13: docs/project5.jpeg]
