mkvesala/CMPS14-ESP32-SignalK-gateway/docs/paths.jpeg

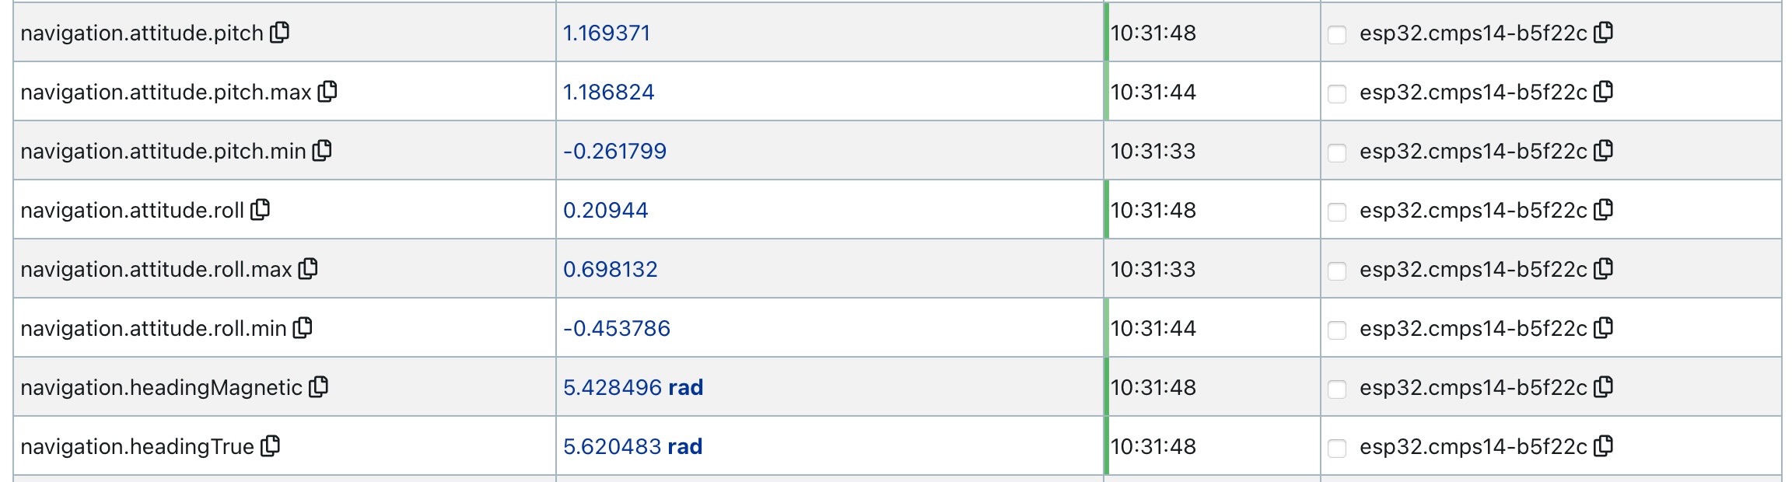
docs/paths.jpeg
