mkvesala/CMPS14-ESP32-SignalK-gateway/CMPS14Application.h

#pragma once

#include <Arduino.h>
#include <Wire.h>
#include <WiFi.h>
#include <ArduinoOTA.h>
#include <esp_system.h>
#include <esp_wifi.h>
#include "WifiState.h"
#include "CMPS14Sensor.h"
#include "CMPS14Processor.h"
#include "CMPS14Preferences.h"
#include "SignalKBroker.h"
#include "DisplayManager.h"
#include "WebUIManager.h"
#include "ESPNowBroker.h"

// === C M P S 1 4 A P P L I C A T I O N  C L A S S ===
//
// - Class CMPS14Application - "the app" responsible for orchestrating everything
// - Owns:
//   - CMPS14Sensor, "the sensor"
//   - CMPS14Processor, "the compass"
//   - CMPS14Preferences, "the compass_prefs"
//   - SignalKBroker, "the signalk"
//   - DisplayManager, "the display"
//   - WebUIManager, "the webui"
//   - ESPNowBroker, "the espnow"
// - Uses: WifiState, CalMode
// - Init: app.begin() - called in setup() of the main program
// - Loop: app.loop() - called in loop() of the main program
// - Critical check: app.compassOk() - without the compass, well, it's not a compass

class CMPS14Application {

  public:
  
    explicit CMPS14Application();

    void begin();
    void loop();
    bool compassOk() const { return compass_ok; }

  private:

    // CMPS14 I2C address
    static constexpr uint8_t CMPS14_ADDR = 0x60;

    // SH-ESP32 default pins for I2C
    static constexpr uint8_t I2C_SDA = 16;
    static constexpr uint8_t I2C_SCL = 17;

    static constexpr unsigned long MIN_TX_INTERVAL_MS    = 101;         // Max frequency for sending deltas to SignalK
    static constexpr unsigned long READ_MS               = 47;          // Frequency to read values from CMPS14 in loop()
    static constexpr unsigned long CAL_POLL_MS           = 499;         // Frequency to poll calibration status in loop() 
    static constexpr unsigned long WIFI_STATUS_CHECK_MS  = 503;         // Frequency to check wifi status
    static constexpr unsigned long WIFI_TIMEOUT_MS       = 14983;   // One STA connect attempt (was 179999)
    static constexpr unsigned long WIFI_RETRY_MS         = 29989;   // First wait before a WiFi retry
    static constexpr unsigned long WIFI_RETRY_MAX_MS     = 119993;  // WiFi retry backoff ceiling
    // ESP-NOW channel — must equal the router's fixed WiFi channel and the receivers' channel
    static constexpr uint8_t ESPNOW_CHANNEL = 6;
    static constexpr unsigned long WS_RETRY_MS           = 1999;        // Shortest reconnect delay for SignalK websocket
    static constexpr unsigned long WS_RETRY_MAX_MS       = 119993;      // Max reconnect delay for SignalK websocket
    static constexpr unsigned long WS_PING_MS            = 9973;        // Client WebSocket ping cadence (~10 s) — liveness probe
    static constexpr unsigned long ESPNOW_TX_INTERVAL_MS = 53;          // Frequency for ESP-NOW broadcast
    static constexpr unsigned long MEM_CHECK_MS          = 120007;      // Memory check every 2 mins to LCD - debug
    static constexpr unsigned long RUNTIME_CHECK_MS      = 59999;       // Runtime monitoring of app.loop() - debug
    static constexpr unsigned long RSSI_DISPLAY_MS       = 90007;       // RSSI on LCD ~90s when WiFi connected - debug
    static constexpr unsigned long WS_WATCHDOG_MS        = 599983UL;    // Restart if WiFi up but WebSocket silent for ~10 min
    static constexpr unsigned long LOOP_SAMPLE_CAP_US    = 199999UL;    // Clamp single-iteration outliers (~200 ms) before EMA
    static constexpr unsigned long LOOP_WATCHDOG_US      = 99991UL;     // Restart if loop EMA sustained above ~100 ms

    // Timers
    unsigned long expn_retry_ms         = WS_RETRY_MS;
    unsigned long next_ws_try_ms        = 0;
    unsigned long last_tx_ms            = 0;
    unsigned long last_read_ms          = 0;
    unsigned long last_cal_poll_ms      = 0;
    unsigned long wifi_conn_start_ms    = 0;
    unsigned long wifi_last_check_ms    = 0;
    unsigned long wifi_retry_ms         = WIFI_RETRY_MS;
    unsigned long wifi_next_retry_ms    = 0;
    unsigned long last_espnow_tx_ms     = 0;
    unsigned long last_ws_activity_ms   = 0; // Watchdog: last successful WebSocket open; 0 = never
    unsigned long last_ping_ms          = 0; // Liveness: last client ping sent
    unsigned long last_mem_check_ms     = 0; // Debug
    unsigned long last_runtime_check_ms = 0; // Debug
    unsigned long last_rssi_display_ms  = 0; // Debug

    // Loop runtime monitoring and watchdog
    float loop_avg_us = 0.0f;
    unsigned long loop_peak_us = 0;   // Raw (unclamped) max sample within the current report window
    bool monitoring = false;

    bool compass_ok = false;
    bool wifi_services_initialized = false;
    uint8_t wifi_reconnect_count = 0;

    WifiState wifi_state = WifiState::INIT;

    // AP intruder detection — written in WiFi event callback, read in loop()
    volatile bool ap_intruder = false;
    uint8_t ap_intruder_mac[6] = {};

    // Core instances for app
    CMPS14Sensor sensor;
    CMPS14Processor compass;
    CMPS14Preferences compass_prefs;
    SignalKBroker signalk;
    ESPNowBroker espnow;
    DisplayManager display;
    WebUIManager webui;

    // Handlers for loop - timers and operations
    void handleWifi(const unsigned long now);
    void enterWifiWait(const unsigned long now);
    void handleAPIntruder();
    void handleOTA();
    void handleWebUI();
    void handleWebsocket(const unsigned long now);
    void handleWatchdog(const unsigned long now);
    void handleCompass(const unsigned long now);
    void handleSignalK(const unsigned long now);
    void handleESPNow(const unsigned long now);
    void handleMemory(const unsigned long now); // Debug
    void handleDisplay();

    void initWifiServices();
    void applyStaticIP();

    void monitorLoopRuntime(const unsigned long us); // Debug 
    void handleLoopRuntime(const unsigned long now); // Debug

};
