mkvesala/CMPS14-ESP32-SignalK-gateway/CMPS14Processor.cpp

#include "CMPS14Processor.h"

// === P U B L I C ===

// Constructor
CMPS14Processor::CMPS14Processor(CMPS14Sensor &cmps14Sensor) : sensor(cmps14Sensor), wire(nullptr) {}

// Begin
bool CMPS14Processor::begin(TwoWire &wirePort) {
    wire = &wirePort;
    bool ok = sensor.begin(wirePort);
    if (ok) firmware_version = this->readFwVersion();
    return ok;
}

// Process the values received from CMPS14Sensor::read(...)
bool CMPS14Processor::update() {
    float raw_deg, pitch_raw, roll_raw;

    if (!sensor.read(raw_deg, pitch_raw, roll_raw)) return false;
    
    // Heading (C)
    raw_deg += installation_offset_deg;
    if (raw_deg >= 360.0f) raw_deg -= 360.0f;
    if (raw_deg < 0.0f) raw_deg += 360.0f;
    if (isnan(compass_deg)) {
        compass_deg = raw_deg;
    } else {
        float diff = raw_deg - compass_deg;
        if (diff > 180.0f) diff -= 360.0f;
        if (diff < -180.0f) diff += 360.0f;
        compass_deg += HEADING_ALPHA * diff;
        if (compass_deg >= 360.0f) compass_deg -= 360.0f;
        if (compass_deg < 0.0f) compass_deg += 360.0f;
    }

    // Heading (M)
    dev_deg = dev_lut.lookup(compass_deg);
    heading_deg = compass_deg + dev_deg;
    if (heading_deg >= 360.0f) heading_deg -= 360.0f;
    if (heading_deg < 0.0f) heading_deg += 360.0f;

    // Heading (T)
    heading_true_deg = heading_deg + this->getVariation();
    if (heading_true_deg >= 360.0f) heading_true_deg -= 360.0f;
    if (heading_true_deg < 0.0f) heading_true_deg += 360.0f;

    pitch_level_raw = pitch_raw;
    roll_level_raw = roll_raw;

    pitch_deg = pitch_raw + pitch_level;
    roll_deg = roll_raw + roll_level;

    // Radians for SignalK
    this->updateHeadingDelta();

    return true;
}

// Capture leveling factors for resetting attitude to zero
void CMPS14Processor::level() {
    if (validf(pitch_level_raw) && validf(roll_level_raw)) {
        pitch_level = -pitch_level_raw;
        roll_level = -roll_level_raw;
    }
}

// Reset CMPS14Sensor
bool CMPS14Processor::reset() {
    bool ok =
        sensor.sendCommand(REG_RESET1) &&
        sensor.sendCommand(REG_RESET2) &&
        sensor.sendCommand(REG_RESET3);
    if (!ok) return false;
    delay(599);  // Datasheet recommends delay of 300 ms here
    if (sensor.sendCommand(REG_USEMODE)) {
        cal_mode_runtime = CalMode::USE;
        cal_mode_boot = CalMode::USE;
        cal_profile_stored = false;
        pitch_level = 0.0f;  // Sensor registers reset → clear attitude leveling too
        roll_level = 0.0f;
        return true;
    }
    return false;
}

// Start calibration with desired calibration mode
bool CMPS14Processor::startCalibration(CalMode mode) {
    cal_mode_runtime = mode;
    bool ok = false;
    switch (mode) {
        case CalMode::FULL_AUTO: {
            ok = this->enableBackgroundCal(true);
            full_auto_left_ms = 0;
            full_auto_start_ms = millis();
            break;
        }
        case CalMode::AUTO: 
            ok = this->enableBackgroundCal(false); 
            break;
        case CalMode::MANUAL:
            ok = this->enableBackgroundCal(false);
            break;
        default:
            ok = sensor.sendCommand(REG_USEMODE);
            break;
    }
    return ok;
}

// Stop calibration and return to use-mode
bool CMPS14Processor::stopCalibration() {
    cal_mode_runtime = CalMode::USE;
    return sensor.sendCommand(REG_USEMODE);
}

// Monitor calibration and optionally save calibration profile
void CMPS14Processor::monitorCalibration(bool autosave) {
    uint8_t statuses[4];
    this->requestCalStatus(statuses);
    uint8_t mag = statuses[0], acc = statuses[1], sys = statuses[3];
    if (sys == 3 && acc == 3 && mag == 3) {
        if (cal_ok_count < 255) cal_ok_count++;
    } else cal_ok_count = 0;

    if (autosave && !cal_profile_stored && cal_ok_count >= CAL_OK_REQUIRED) {
        bool ok = 
            sensor.sendCommand(REG_SAVE1) &&
            sensor.sendCommand(REG_SAVE2) && 
            sensor.sendCommand(REG_SAVE3) &&
            sensor.sendCommand(REG_USEMODE);
        if (ok) {
            cal_profile_stored = true;
            cal_mode_runtime = CalMode::USE;
        }
        cal_ok_count = 0;
    }
}

// Start calibration mode or use-mode, default is use-mode, manual never used at boot
bool CMPS14Processor::initCalibrationModeBoot() {
    bool started = false;
    if (!sensor.available()) {
        cal_mode_runtime = CalMode::USE;
        return started;
    }
    switch (cal_mode_boot) {
        case CalMode::FULL_AUTO:
            started = this->startCalibration(CalMode::FULL_AUTO);
            break;
        case CalMode::AUTO:
            started = this->startCalibration(CalMode::AUTO);
            break;
        case CalMode::MANUAL:
            started = this->startCalibration(CalMode::MANUAL);
            break;
        default:
            started = this->stopCalibration();
            break;
    }
    return started;
}   

// Save calibration profile
bool CMPS14Processor::saveCalibrationProfile() {
    bool ok = 
        sensor.sendCommand(REG_SAVE1) &&
        sensor.sendCommand(REG_SAVE2) &&
        sensor.sendCommand(REG_SAVE3) &&
        sensor.sendCommand(REG_USEMODE);
    if (ok) {
        cal_profile_stored = true;
        cal_mode_runtime = CalMode::USE;
    }
    return ok;
}

// Get calibration status by checking the contents of the calibration byte
void CMPS14Processor::requestCalStatus(uint8_t out[4]) {
    uint8_t byte = this->readCalStatusByte();
    uint8_t mag = 255, acc = 255, gyr = 255, sys = 255;
    if (!sensor.isNack(byte)) {
        mag = (byte     ) & REG_MASK;
        acc = (byte >> 2) & REG_MASK;
        gyr = (byte >> 4) & REG_MASK;
        sys = (byte >> 6) & REG_MASK;
    }
    out[0] = mag; out[1] = acc; out[2] = gyr; out[3] = sys;
}

// === P R I V A T E ===

// Enable calibration with optional autosave (built in autosave of CMPS14)
bool CMPS14Processor::enableBackgroundCal(bool autosave) {
    return sensor.sendCommand(REG_CAL1)
        && sensor.sendCommand(REG_CAL2)
        && sensor.sendCommand(REG_CAL3)
        && sensor.sendCommand(autosave ? REG_AUTO_ON : REG_AUTO_OFF);
}

// Read calibration status byte
uint8_t CMPS14Processor::readCalStatusByte() {
    return sensor.readRegister(REG_CAL_STATUS);
}

// Read firmware version byte
uint8_t CMPS14Processor::readFwVersion() {
    return sensor.readRegister(REG_FIRMWARE);
}

// Update values of HeadingDelta struct
void CMPS14Processor::updateHeadingDelta() {
    headingDelta.heading_rad      = heading_deg * DEG_TO_RAD;
    headingDelta.heading_true_rad = heading_true_deg * DEG_TO_RAD;
    headingDelta.pitch_rad        = pitch_deg * DEG_TO_RAD;
    headingDelta.roll_rad         = roll_deg * DEG_TO_RAD;
}
