mkvesala/CMPS14-ESP32-SignalK-gateway/DisplayManager.h

#pragma once

#include <Arduino.h>
#include <Wire.h>
#include <LiquidCrystal_I2C.h>
#include "WifiState.h"
#include "CalMode.h"
#include "CMPS14Processor.h"
#include "SignalKBroker.h"

// === D I S P L A Y M A N A G E R  C L A S S ===
//
// - Class DisplayManager - "the display" responsible for LCD and LEDs
// - Init: display.begin()
// - Provides public API to
//   - Handle message queue at regular intevals (fifo) for LCD
//   - Handle LED updates
//   - Show messages on LCD (through fifo message queue)
//   - Set and get wifi connection status info
// - Message queue works on fifo basis and the clock speed of
//   the queue can be adjusted with LCD_MS constant
// - Uses: CMPS14Processor ("the compass"), SignalKBroker ("the signalk"), WifiState, CalMode
// - Owns: LiquidCrystal_I2C
// - The idea is that the class can be re-implemented if switching to other kinda displays
//   while keeping the public API intact for backwards compatibility

class DisplayManager {

  public:

    explicit DisplayManager(CMPS14Processor &compassref, SignalKBroker &signalkref);

    bool begin();
    void handle();
    
    void showSuccessMessage(const char* who, bool success);
    void showInfoMessage(const char* who, const char* what);
    void showWifiStatus();
    
    [[deprecated("Use setWifiInfo(int32_t rssi, uint32_t ip) instead")]]
    void setWifiInfo(int32_t rssi, uint8_t ip0, uint8_t ip1, uint8_t ip2, uint8_t ip3);
    
    void setWifiInfo(int32_t rssi, uint32_t ip);
    
    void setWifiState(WifiState state);

    const char* getWifiQuality() const { return RSSIc; }
    const char* getWifiIPAddress() const { return IPc; }

  private:

    // LCD
    void updateLCD(const char* l1, const char* l2);
    bool initLCD();
    void showHeading();
    bool i2cAvailable(uint8_t addr);
    void copy16(char* dst, const char* src);
    
    // Wifi info
    void setRSSIc(int32_t rssi);

    [[deprecated("Use setIPc(uint32_t ip) instead")]]
    void setIPc(uint8_t ip0, uint8_t ip1, uint8_t ip2, uint8_t ip3);
    
    void setIPc(uint32_t ip);

    // Fifo
    bool pushMsgItem(const auto &msg);
    bool popMsgItem(auto &msg);
    bool fifoIsEmpty() const { return count == 0; }
    bool fifoIsFull() const { return count == FIFO_SIZE; }

    // LEDs
    void updateBlueLed();
    void updateGreenLed();
    void setLedState(uint8_t pin, bool &current_state, bool new_state);

    CMPS14Processor &compass;
    SignalKBroker &signalk;
    LiquidCrystal_I2C lcd;

    static constexpr uint8_t LED_PIN_BL = 2;
    static constexpr uint8_t LED_PIN_GR = 13;
    static constexpr uint8_t LCD_ADDR = 0x27;
    static constexpr uint8_t FIFO_SIZE = 16;
    static constexpr unsigned long LCD_MS = 1499;
                       
    unsigned long last_lcd_ms = 0;

    // FIFO queue for LCD printing
    struct MsgItem {
      char l1[17];
      char l2[17];
    };

    MsgItem fifo[FIFO_SIZE];
    uint8_t head = 0;   // index to write next
    uint8_t tail = 0;   // index to read next
    uint8_t count = 0;  // number of items in the buffer

    // Wifi info
    char RSSIc[16];
    char IPc[16];

    // Wifi state
    WifiState wifi_state = WifiState::INIT;

    // LCD content for strcmp
    char prev_top[17] = "";
    char prev_bot[17] = "";

    bool lcd_present = false;

    // Track the GPIO state of leds
    bool blue_led_current_state = false;
    bool green_led_current_state = false;

};
