mkvesala/CMPS14-ESP32-SignalK-gateway/CMPS14Preferences.h

#pragma once

#include <Arduino.h>
#include <Preferences.h> 
#include "CMPS14Processor.h"
#include "harmonic.h"
#include "CalMode.h"
#include "ResetReason.h"

// === C M P S 1 4 P R E F E R E N C E S  C L A S S ===
//
// - Class CMPS14Preferences - "the compass_prefs" responsible for managing ESP32 NVS
// - Provides public API to save config persistently to NVS
//   - Installation offset
//   - Pitch/roll leveling (attitude zeroing)
//   - Manual variation
//   - Measured deviations at 8 cardinal/intercardinal points
//   - Computed 5 coefficients for deviation calculation
//   - Compass calibration mode to be loaded at ESP32 boot
//   - Timeout for FULL AUTO calibration mode
//   - Heading mode: HDG(T) / HDG(M)
//   - Reason for the latest restart, consumed on boot
// - Provides public API to load config from NVS
// - Provides public API to save and load sha password for web UI
// - Uses: CMPS14Processor ("the compass"), CalMode
// - Owns: Preferences

class CMPS14Preferences {
public:

    explicit CMPS14Preferences(CMPS14Processor &compassref);

    void load();
    void saveInstallationOffset(float offset);
    void saveLevel(float pitch_level, float roll_level);
    void saveManualVariation(float deg);
    void saveDeviationSettings(const float dev[8], const HarmonicCoeffs &hc);
    void saveCalibrationSettings(CalMode mode, unsigned long ms);
    void saveSendHeadingTrue(bool enable);
    void saveWebPassword(const char* password_sha256_hex);
    bool loadWebPasswordHash(char* out_hash_64bytes);
    void saveResetReason(ResetReason reason);
    ResetReason getLastResetReason() const { return last_reset; }

private:
    const char* ns = "cmps14";
    Preferences prefs;
    CMPS14Processor &compass;
    ResetReason last_reset = ResetReason::NONE;   // populated by load(), then cleared in NVS
};
