mkvesala/CMPS14-ESP32-SignalK-gateway/secrets.example.h

#pragma once

// === C R E D E N T I A L S ===
//
// - Rename the file --> secrets.h
// - Replace the dummy credentials with yours

inline constexpr const char* WIFI_SSID = "your_wifi_ssid_here";
inline constexpr const char* WIFI_PASS = "your_wifi_password_here";
inline constexpr const char* SK_HOST = "your_signalk_address_here";
inline constexpr uint16_t SK_PORT = 3000; // <-- replace with your signalk server port
inline constexpr const char* SK_TOKEN = "your_signalk_auth_token_here";
inline constexpr const char* OTA_PASS = "your_OTA_password_here";
inline constexpr const char* DEFAULT_WEB_PASSWORD = "your_default_web_password_here";
inline constexpr const char* AP_SSID = "your_ap_ssid_here";   // hidden, name not critical
inline constexpr const char* AP_PASS = "your_ap_password_here"; // min 8 chars (WPA2)
inline constexpr const char* WIFI_STATIC_IP = "192.168.1.55";  // TODO: verify outside DHCP pool
inline constexpr const char* WIFI_GATEWAY = "192.168.1.1";
inline constexpr const char* WIFI_SUBNET = "255.255.255.0";

// Static API token for machine clients (e.g. the MCP tool). Empty = token auth disabled.
// Sent by the client in the "X-Auth-Token" header; grants access without a browser session.
// Use a long random value, e.g. 32+ hex chars. Rotate = change here and reflash.
inline constexpr const char* MCP_API_TOKEN = "";
