mkvesala/CMPS14-ESP32-SignalK-gateway/(commit log)

2025-10-31 Initial commit of CMPS14-ESP32-SignalK-gateway.
2025-11-06 Tidying up code and added ArduinoJson handling for status block. Checkbox for true heading mode does not work, will be replaced by radiobuttons.
    [CMPS14-ESP32-SignalK-gateway.ino]
2025-11-06 Changed heading mode handling from checkbox to radio button. NOT TESTED.
2025-11-07 Debug version, preferences not working correctly. DEBUG.
    [CMPS14-ESP32-SignalK-gateway.ino]
2025-11-07 Shortened magvar_manual_deg key in prefs. Changed Strings to char arrays in globals.
    [CMPS14-ESP32-SignalK-gateway.ino]
2025-11-07 Removed decimals from Web UI values. Added cmps14 I2C availablity checks in setup() and loop().
2025-11-08 Fixed errors with REG_ names.
    [CMPS14-ESP32-SignalK-gateway.ino]
2025-11-09 Solved deviation handling. Autocal on boot is under DEBUG.
    [CMPS14-ESP32-SignalK-gateway.ino]
2025-11-09 Before adding three calibration modes.
2025-11-09 Added 3 calibration modes on boot. Fixed the timer / boolean problem in loop() causing unwanted behavior in cmps14_monitor_and_store().
    [CMPS14-ESP32-SignalK-gateway.ino]
2025-11-10 Added ESP32 software restart and blue led calibration mode indicator.
2025-11-10 Added ESP32 software restart button to Web UI. Fixing html and javascript parts.
    [CMPS14-ESP32-SignalK-gateway.ino]
2025-11-11 Tidying deviation table. Trying to switch deviation curve x and y axis.
2025-11-12 Tidying Web UI and deviation table & curve. Added green led connectivity indicator.
2025-11-14 Fixed LCD refresh in loop().
    [CMPS14-ESP32-SignalK-gateway.ino]
2025-11-14 Fixed LCD info messages hold time. Added skeleton for to-be h/cpp files.
    [CMPS14-ESP32-SignalK-gateway.ino]
2025-11-15 Fixed delta sending timer inconsisency.
    [CMPS14-ESP32-SignalK-gateway.ino]
2025-11-18 Shortened READ_MS and MIN_TX_INTERVAL_MS. Included display.h in cmps14.h. Changed full auto mode monitoring in loop() so that variable left is not unsigned. Resetting also heading_true_deg and _rad t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
    [CMPS14-ESP32-SignalK-gateway.ino]
2025-11-19 Initialize README with project details and features
    Added detailed project description and features for the CMPS14-ESP32-SignalK Gateway.
2025-11-20 Refactor README for clarity and updates
    Rearranged sentences for better clarity and flow. Updated descriptions for OTA updates and preferences, and improved explanations for calibration modes and web UI.
2025-11-20 Revise SignalK communication and documentation format
    Updated sections on SignalK communication and webserver endpoints, added calibration modes, and improved formatting for libraries and credits.
2025-11-23 Moved delta send timers from SignalK.cpp to loop() for clarity.
2025-11-23 Moved cmps14_monitor_and_store() timer to loop(). For clarity.
2025-11-24 Modify blinking frequency for FULL AUTO mode
    Updated blinking frequency description for FULL AUTO calibration mode.
2025-12-01 Refactoring: moved heading, pitch, roll and minmax values under CMPS14Processor.
2025-12-07 Refactoring: moved full_auto_xx_ms timers to CMPS14Processor.
2025-12-08 Refactoring: moved timer consts to .ino and CMPS14 instances under CMPS14instances.cpp
2025-12-17 Fixing couple of issues in CMPS14Application
    [CMPS14Application.cpp, CMPS14Application.h]
2025-12-19 Enhance README with serial output details
    Added serial communication for angle, pitch, and roll readings.
2025-12-19 Implemented leveling to level pitch and roll.
2025-12-20 Fine tuned leveling implementation of pitch and roll.
2025-12-21 Fixed the issue with tail index in fifo of DisplayManager.
    [DisplayManager.cpp]
2025-12-21 Replaced String handling from WebUIManager with char comparisons. Changed the web UI http parameters accordingly.
    [WebUIManager.cpp]
2025-12-22 Replaced double -> float in harmonic.cpp. Removed std::unique_ptr from LCD, using now normal class member.
    [DisplayManager.cpp, DisplayManager.h, harmonic.cpp]
2025-12-24 Changed wifi connecting from setup() to loop() so that it's not blocking anymore. The program stays responsive and wifi gets connected in the loop() unless timeout reached. Then, or at failure, wifi 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
    [CMPS14-ESP32-SignalK-gateway.ino, CMPS14Application.cpp, CMPS14Application.h]
2025-12-26 Fixed the uint8_t issue with DeviationLookup SIZE constant, now int istead. Added some additional checks for index/value validity in DeviationLookup too.
    [CMPS14Processor.h, WebUIManager.cpp, harmonic.cpp, harmonic.h]
2025-12-27 Added a wrapper DisplayManager::setLedState(..) to avoid unnecessary GPIO writings.
    [DisplayManager.cpp, DisplayManager.h]
2025-12-28 Replaced Wifi API calls in DisplayManager with a wifi_state that is set by CMPS14Application. Switched green and blue led, now green led is calibration mode and blue led connection status.
    [CMPS14Application.cpp, DisplayManager.cpp, DisplayManager.h, harmonic.h]
2025-12-28 Revise README for release history and LED indicators
    Updated release history and clarified LED indicator descriptions.
2025-12-30 Update README with hardware setup note
    Added a note about completing the hardware setup with soldered wiring.
2025-12-30 Revise loop runtime and stack metrics in README
    Updated performance metrics for release v1.0.0 on SH-ESP32.
2026-01-01 Added a schematic and updated README/CONTRIBUTING
2026-01-02 Add hyperlinks to development board and software
    Updated README to include hyperlinks for better reference.
2026-01-18 String handling replaced with C-string operations in authentication methods.
    [WebUIManager.cpp, WebUIManager.h]
2026-01-18 Updated CHANGELOG, README and added a debug LCD print to login
2026-01-20 Added debug printing to handleLogin
2026-01-20 Fixed c_str() issue in authentication methods of WebUIManager as well as session cookie setting issue.
    [WebUIManager.cpp, WebUIManager.h]
2026-01-22 Replaced a fully blocking delay() in handleLogin() and handleChangePassword() to a IP based login attempt throttling
    [WebUIManager.cpp, WebUIManager.h]
2026-01-22 Changed login throttle follow up to full client ip
2026-01-28 Add Crow Panel 2.1" integration plan documentation
    Comprehensive architecture plan for integrating Elecrow Crow Panel 2.1"
    round touch display with CMPS14-ESP32-SignalK-gateway compass system.
    Includes:
    - ESP-NOW communication protocol design (binary, 20 bytes)
    - Three-phase implementation roadmap (basic/calibration/config)
    - Detailed Phase 1 specifications with code skeletons
    - UI layout design for 480x480 round display
    - Getting started guide for development
    https://claude.ai/code/session_013Nb9iAcW6Sofhs62YG7ZSY
2026-01-31 Fixed a signature compliancy in onDataSent callback
    [ESPNowBroker.cpp, ESPNowBroker.h]
2026-04-07 Documentation patch: updated README with reference to a shared UML class diagram (master in ESP32-Crowpanel-compass repo).
2026-05-01 Commented out the AP-security to debug the Crowpanel level issue. Updated deadbands to be half of what they were.
    [CMPS14Application.cpp, ESPNowBroker.h, SignalKBroker.h]
2026-05-02 Fixed the WiFi reconnect issue causing repeating initWiFiServices() calls. Updated deadbands to 0.05°
    [CMPS14Application.cpp, CMPS14Application.h, ESPNowBroker.h, SignalKBroker.h]
2026-05-02 Updated min and max paths. Fixed the roll and pitch sending issue
    [SignalKBroker.cpp, SignalKBroker.h]
2026-05-19 Added a watchdog to detect an anomaly in Wifi/Websocket connectivity and to perform a self-restart if stuck in reconnect loop
    [CMPS14Application.cpp, CMPS14Application.h]
2026-05-29 Fixed if structure in handleWebsocket() which caused a jamming reconnect issue
    [CMPS14Application.cpp]
2026-07-05 Implemented Python based MCP-tool and the endbpoints in CMPS14 firmware to get and set deviations for 8 cardinal and intercardinal compass bearings. To be used by a Claude Desktop agent.
2026-07-20 Implemented reset reason save in NVS and reporting in status endpoint
    [CMPS14Application.cpp, CMPS14Preferences.cpp, CMPS14Preferences.h, ResetReason.h, WebUIManager.cpp]
2026-10-12 Release v2.1.3: subscribe magvar on heading mode switch
    Switching heading mode from Magnetic to True on the web UI while the
    SignalK WebSocket was open left the gateway on manual variation until
    the next reconnect, because navigation.magneticVariation was only
    subscribed in the ConnectionOpened event.
    SignalKBroker::handleVariationDelta() is renamed to the public
    subscribeVariation() and is now also called from
    WebUIManager::handleSetHeadingMode(). It sends the subscription only
    when the socket is open and at most once per connection, so toggling
    the mode does not stack duplicate subscriptions on the server.
    Docs: README MCP integration section, MCP_API_TOKEN in the secrets
    example, API to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
2026-11-07 Release v2.1.4: sync shared espnow_protocol.h (HALMET_OIL_DELTA)
    Adds message type 10 HALMET_OIL_DELTA and the HALMETOilDelta payload struct,
    copied byte-identically from the fleet-wide header. Wire format and firmware
    logic of this gateway unchanged.
2026-11-09 Release v2.1.5: keep ESP-NOW running and retry WiFi after router outage
    handleWifi() no longer turns the radio off (WiFi.mode(WIFI_OFF)) after a
    failed or timed-out connection attempt. The STA idles in DISCONNECTED with
    the radio on and the channel held at ESPNOW_CHANNEL (6), and retries every
    ~30 s to ~2 min, so ESP-NOW keeps working while the router is down and
    WiFi and SignalK recover without a power cycle. Soft AP moved to channel 6,
    core auto-reconnect disabled.
2026-11-14 Release v2.1.6: migrate to ArduinoJson 7 API
    Replace the ArduinoJson 6-style calls that ArduinoJson 7 deprecates
    (StaticJsonDocument, createNestedArray, createNestedObject, containsKey) with JsonDocument, to<T>(), is<T>() and add<T>().
    The old calls were inline wrappers for exactly these, so the JSON sent
    to SignalK is byte-for-byte the same.
    Skip a send when the document overflowed (heap exhausted) instead of
    sending a partial message, and let the next cycle send it.
    Incoming deltas are parsed with a filter that keeps only
    updates[].values[].path/value, the only fields read.
    Verified with a host SignalK simulation (main vs this commit: identical
    frames, no heap growth, allocation fault in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
