mkvesala/CMPS14-ESP32-SignalK-gateway/(notices)

Notices in the files:
README.md:
License: MIT
